WyerFrameZ/vfd-spectrum-analyzer/3d/stand_vfd.stl

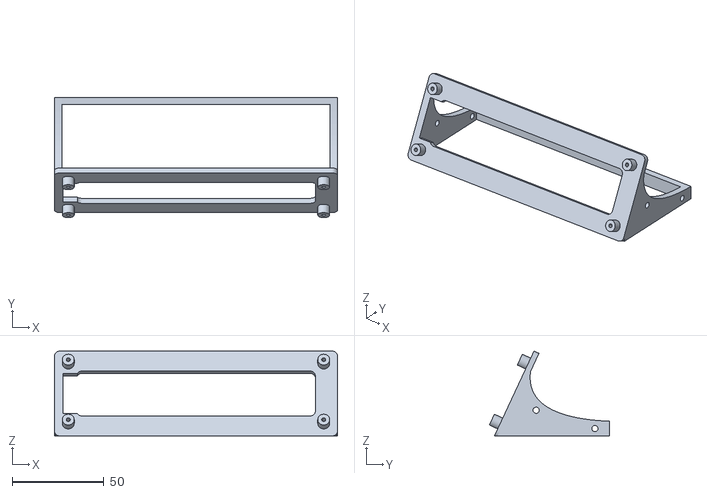
[picture p6: CAD file, 2026-10-27]
3d/stand_vfd.stl
154.0 x 65.5 x 46.2
