WyerFrameZ/vfd-spectrum-analyzer/(commit log)

2026-10-27 VFD spectrum analyzer: firmware, PC app, per-app capture, schematic, 3D stand
    [stand_vfd.stl, vfd-spectrum.kicad_sch]
2026-10-27 Add breadboard-style wiring diagram
2026-10-27 Wiring diagram from a real VFD photo and the Fritzing Arduino UNO graphic
2026-10-27 Fritzing-style wiring diagram: breadboard, DC jack, capacitors, curved jumper wires
